BlakeGarner/blakegarner-kicad-library/README.md

# user-kicad-library
Blake's KiCad Library
