BlakeGarner/blakegarner-kicad-library/kicad-packages3d/Button_Switch_BG/src/TE_Alcoswitch_SPST_LED.FCStd

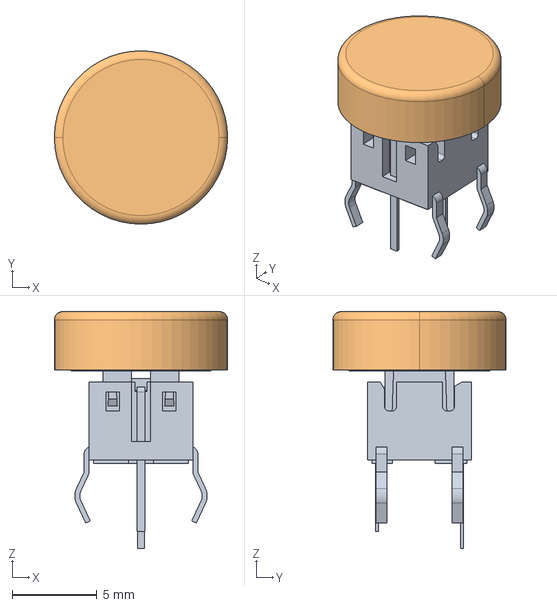
[picture p2: CAD file, 2020-06-05]
kicad-packages3d/Button_Switch_BG/src/TE_Alcoswitch_SPST_LED.FCStd
10.2 x 10.2 x 13.9 mm
SwitchChassis
SwitchCapRound
