BlakeGarner/blakegarner-kicad-library/kicad-packages3d/Button_Switch_BG/TE_Alcoswitch_SPST_LED_SquareCapBlack.step

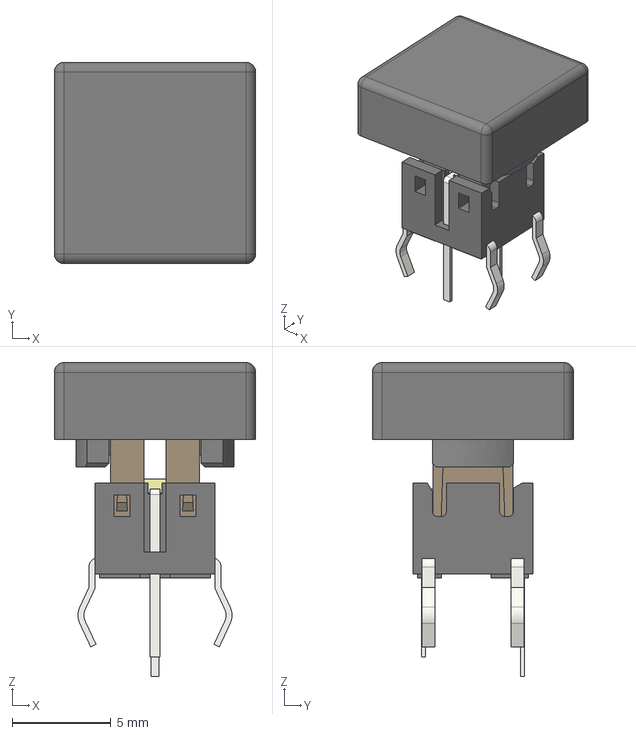
[picture p3: CAD file, 2020-09-09]
kicad-packages3d/Button_Switch_BG/TE_Alcoswitch_SPST_LED_SquareCapBlack.step
10.2 x 10.2 x 15.9 mm
