BlakeGarner/blakegarner-kicad-library/kicad-packages3d/Connector_BG/00BarrierBlock_TE_1x02_P0.375in_6DBL-02-006.stp

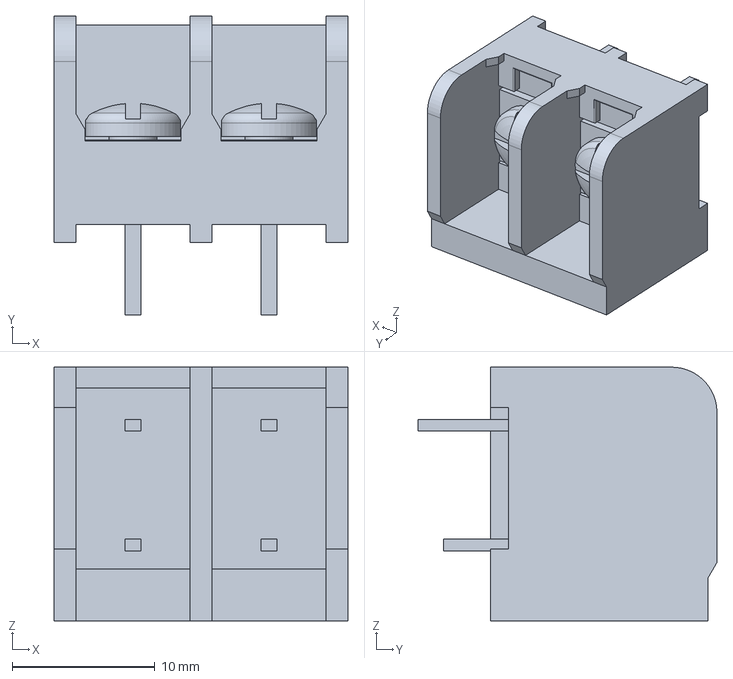
[picture p4: CAD file, 2019-09-27]
kicad-packages3d/Connector_BG/00BarrierBlock_TE_1x02_P0.375in_6DBL-02-006.stp
20.6 x 21.0 x 17.8 mm
