BlakeGarner/blakegarner-kicad-library/kicad-packages3d/Display_BG/0.91in_OLED_Module_Without_Glass.step

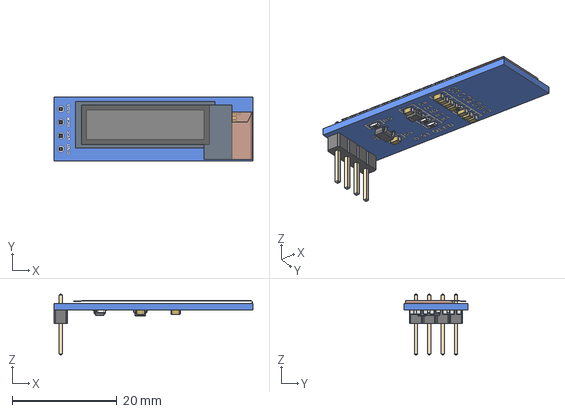
[picture p6: CAD file, 2019-06-12]
kicad-packages3d/Display_BG/0.91in_OLED_Module_Without_Glass.step
37.9 x 12.1 x 11.5 mm
