BlakeGarner/blakegarner-kicad-library/kicad-packages3d/Display_BG/src/Display_OLED_128x32_I2C.FCStd

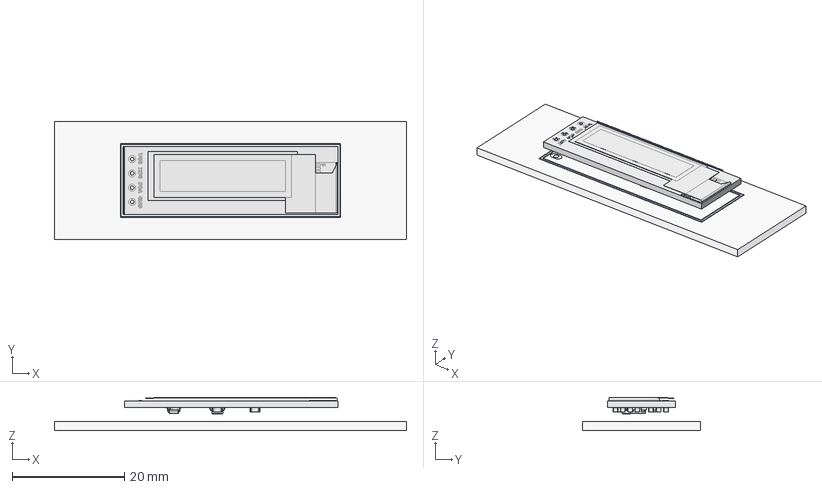
[picture p7: CAD file, 2019-06-12]
kicad-packages3d/Display_BG/src/Display_OLED_128x32_I2C.FCStd
62.6 x 21.0 x 5.89 mm
FCrtYd
FrontSilk
TopPads
BotPads
PTHs
Pcb
__91in_OLED_Module___Without_Glass_cp
