BlakeGarner/blakegarner-kicad-library/kicad-packages3d/Encoder_BG/PEC12R-4X20F-SXXX.step

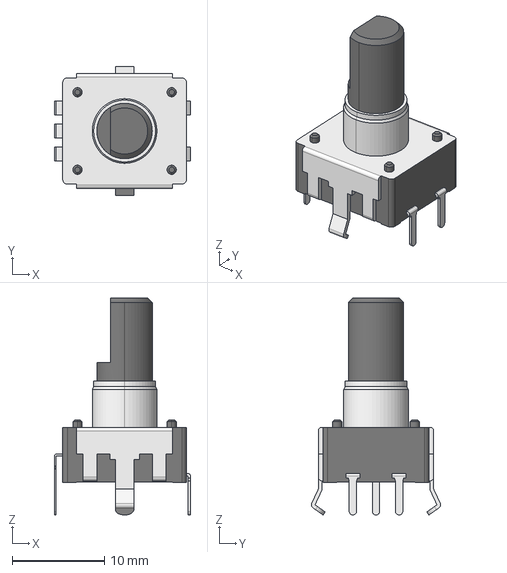
[picture p8: CAD file, 2019-06-12]
kicad-packages3d/Encoder_BG/PEC12R-4X20F-SXXX.step
14.7 x 14.0 x 23.5 mm
