BlakeGarner/blakegarner-kicad-library/kicad-packages3d/Encoder_BG/src/PEC11R-4x20k-Sxxxx.FCStd

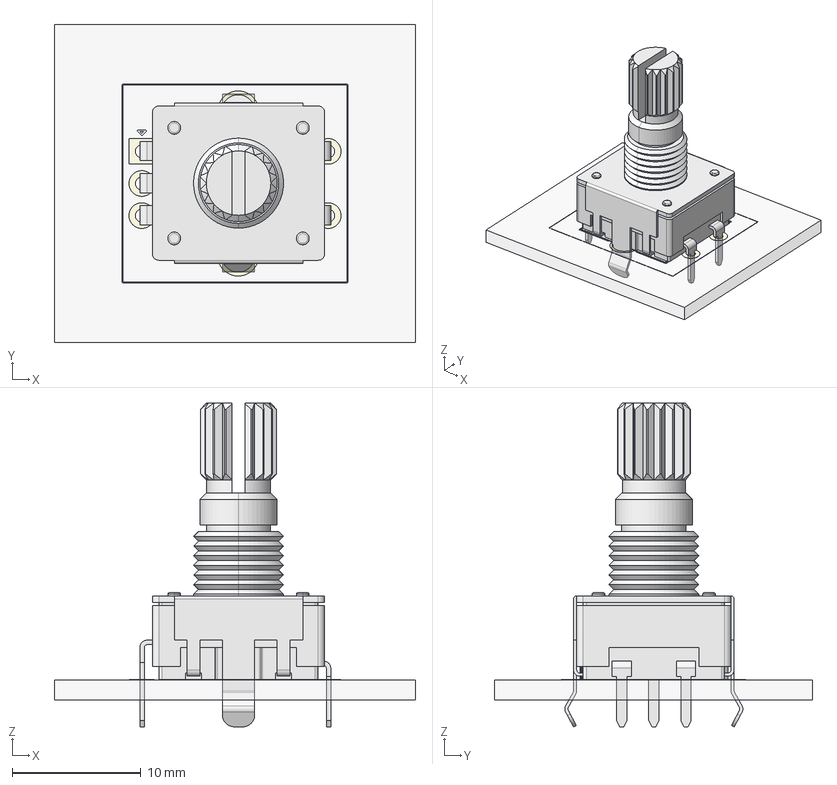
[picture p9: CAD file, 2019-06-12]
kicad-packages3d/Encoder_BG/src/PEC11R-4x20k-Sxxxx.FCStd
28.1 x 24.7 x 25.2 mm
FCrtYd
FFab
FrontSilk
TopPads
BotPads
PTHs
Pcb
PEC11R_4215K_L13_8_W12_4_H21_5_cp001_cp
