BlakeGarner/blakegarner-kicad-library/kicad-packages3d/Encoders/PEC11R-4x20k-Sxxxx.step

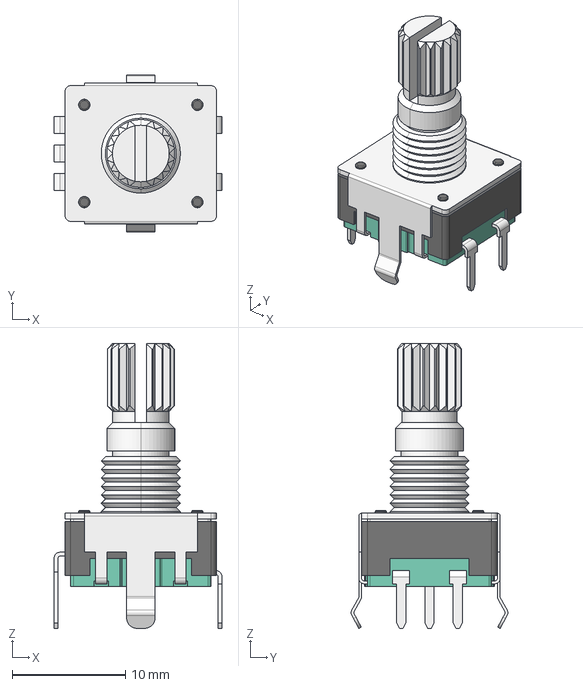
[picture p10: CAD file, 2019-06-10]
kicad-packages3d/Encoders/PEC11R-4x20k-Sxxxx.step
14.9 x 13.9 x 25.2 mm
