BlakeGarner/blakegarner-kicad-library/kicad-packages3d/Fuse_BG/BladeFuse_ATO_Keystone_3557-2.stl

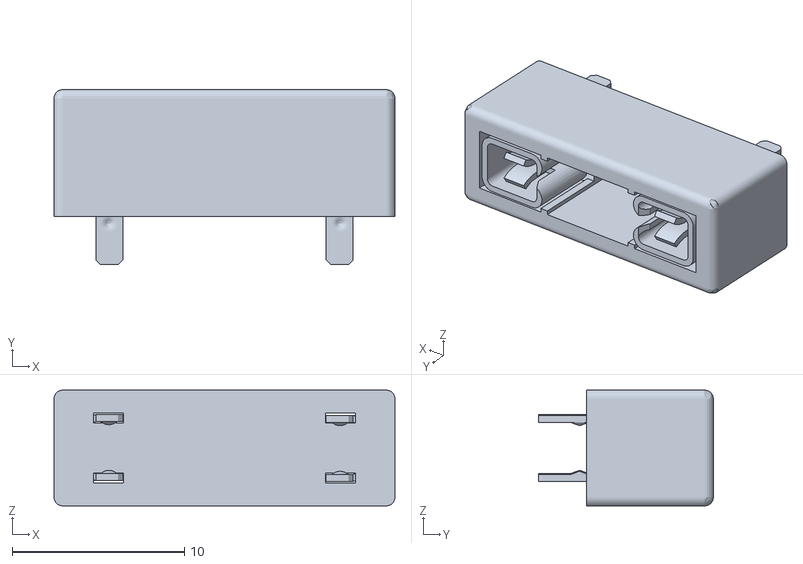
[picture p11: CAD file, 2019-09-27]
kicad-packages3d/Fuse_BG/BladeFuse_ATO_Keystone_3557-2.stl
19.8 x 10.2 x 6.73
