BlakeGarner/blakegarner-kicad-library/kicad-packages3d/Inductor_BG/Inductor_SMD_12x12mm.step

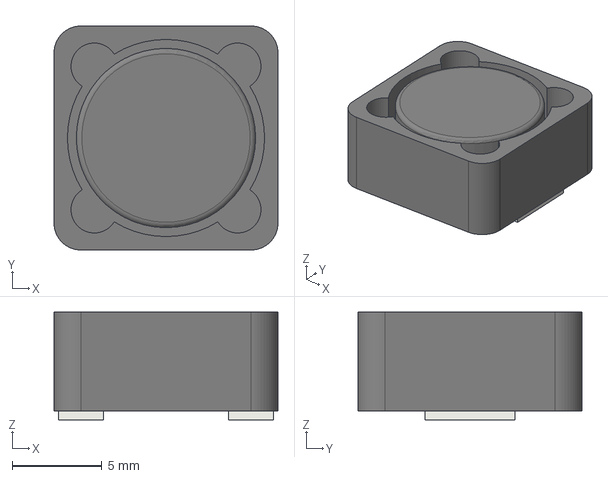
[picture p12: CAD file, 2019-09-27]
kicad-packages3d/Inductor_BG/Inductor_SMD_12x12mm.step
12.5 x 12.5 x 6.00 mm
