BlakeGarner/blakegarner-kicad-library/kicad-packages3d/LED_BG/LED_PLCC2.step

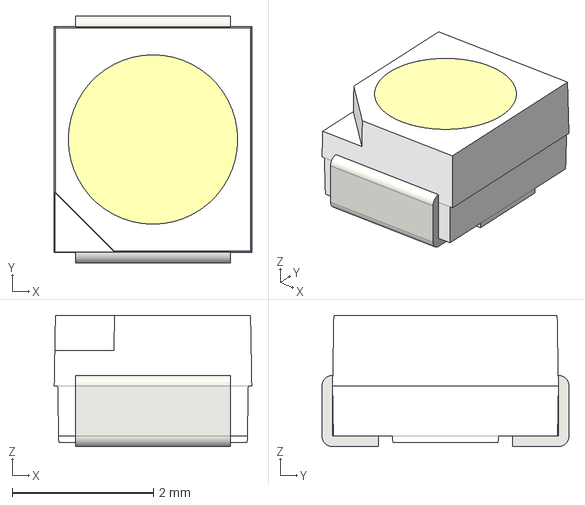
[picture p13: CAD file, 2019-09-27]
kicad-packages3d/LED_BG/LED_PLCC2.step
2.80 x 3.50 x 1.86 mm
