BlakeGarner/blakegarner-kicad-library/kicad-packages3d/LED_BG/src/LED_CREE_CLM1B-M.step

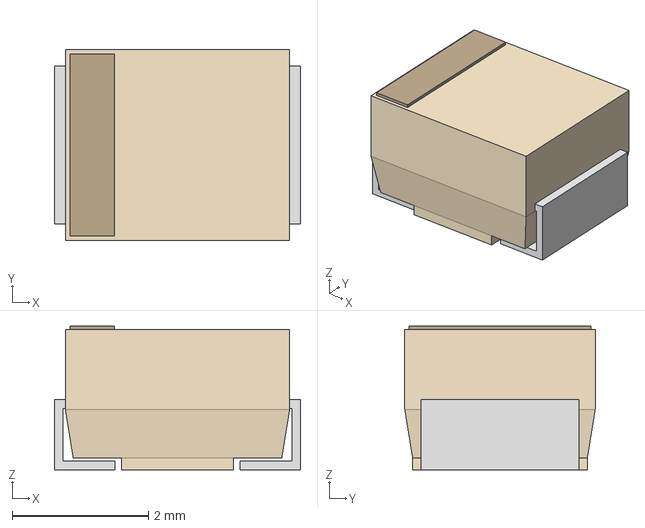
[picture p14: CAD file, 2019-09-27]
kicad-packages3d/LED_BG/src/LED_CREE_CLM1B-M.step
3.61 x 2.79 x 2.11 mm
