BlakeGarner/blakegarner-kicad-library/kicad-packages3d/Module_Meanwell_BG/Meanwell_NSD15_S_cp.step

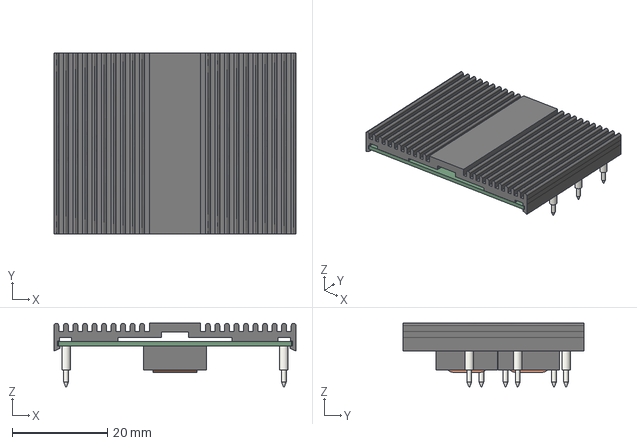
[picture p15: CAD file, 2019-09-27]
kicad-packages3d/Module_Meanwell_BG/Meanwell_NSD15_S_cp.step
50.8 x 38.1 x 13.3 mm
