BlakeGarner/blakegarner-kicad-library/kicad-packages3d/Module_Meanwell_BG/src/Meanwell_NSD15-S.FCStd

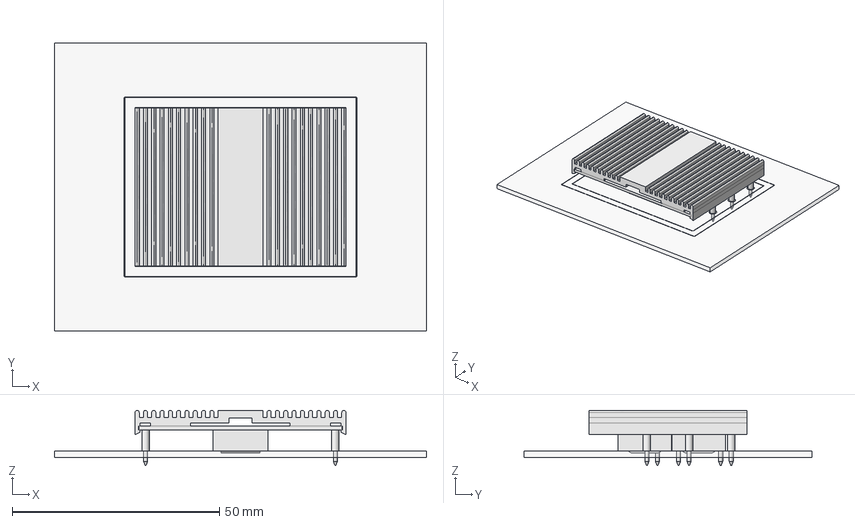
[picture p16: CAD file, 2019-09-27]
kicad-packages3d/Module_Meanwell_BG/src/Meanwell_NSD15-S.FCStd
89.6 x 69.3 x 13.3 mm
FCrtYd
FFab
TopPads
BotPads
PTHs
Pcb
Meanwell_NSD15_S_cp
