BlakeGarner/blakegarner-kicad-library/kicad-packages3d/Module_RaspberryPi_BG/RaspberryPi_3BPlus_Headers_cp.step

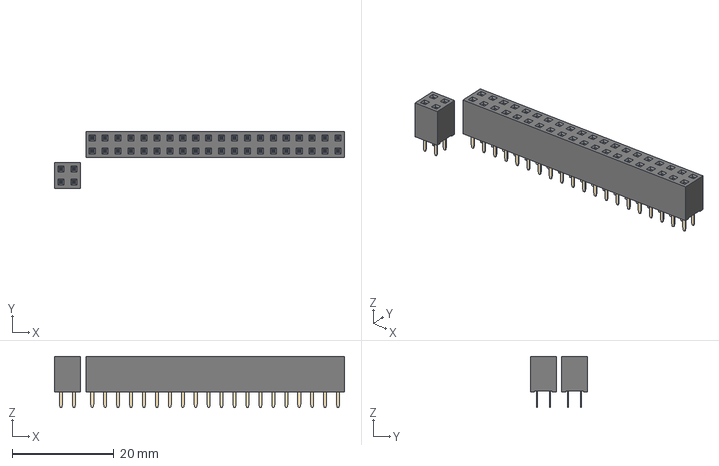
[picture p17: CAD file, 2019-09-27]
kicad-packages3d/Module_RaspberryPi_BG/RaspberryPi_3BPlus_Headers_cp.step
56.9 x 11.2 x 10.1 mm
