BlakeGarner/blakegarner-kicad-library/kicad-packages3d/Module_RaspberryPi_BG/src/raspberry_pi_4_full_model/Microphone Plug, RPi4ModelB.SLDPRT

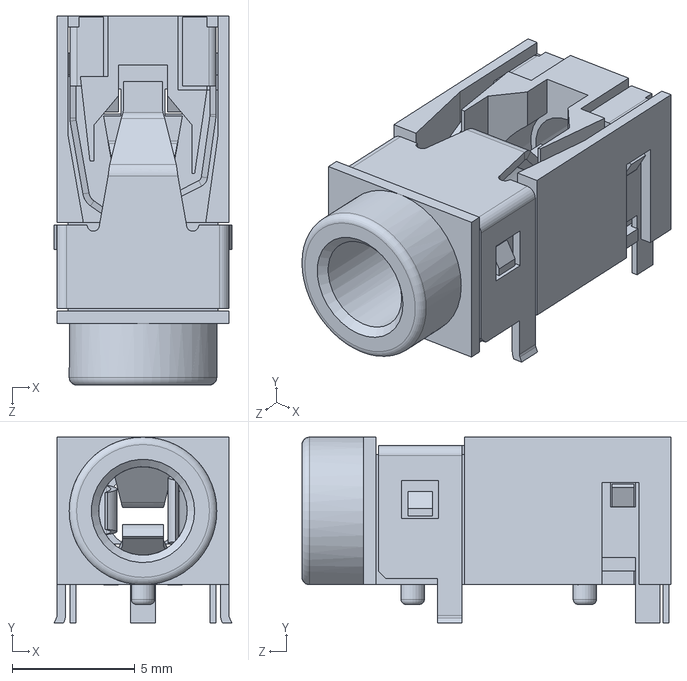
[picture p18: CAD file, 2019-09-30]
kicad-packages3d/Module_RaspberryPi_BG/src/raspberry_pi_4_full_model/Microphone Plug, RPi4ModelB.SLDPRT
7.23 x 7.55 x 15.0 mm
