BlakeGarner/blakegarner-kicad-library/kicad-packages3d/Module_RaspberryPi_BG/src/RaspberryPi_3BPlus.FCStd

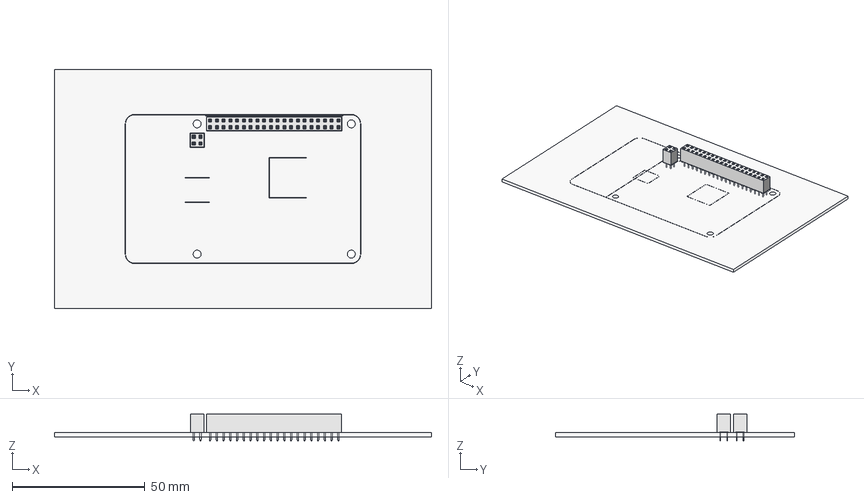
[picture p19: CAD file, 2019-09-27]
kicad-packages3d/Module_RaspberryPi_BG/src/RaspberryPi_3BPlus.FCStd
141.8 x 89.8 x 10.1 mm
FCrtYd
FFab
FrontSilk
TopPads
BotPads
PTHs
Pcb
RaspberryPi_3BPlus_Headers_cp
