BlakeGarner/blakegarner-kicad-library/kicad-packages3d/SOIC_BG/SOIC-8_5.3x5.3mm_P1.27mm.step

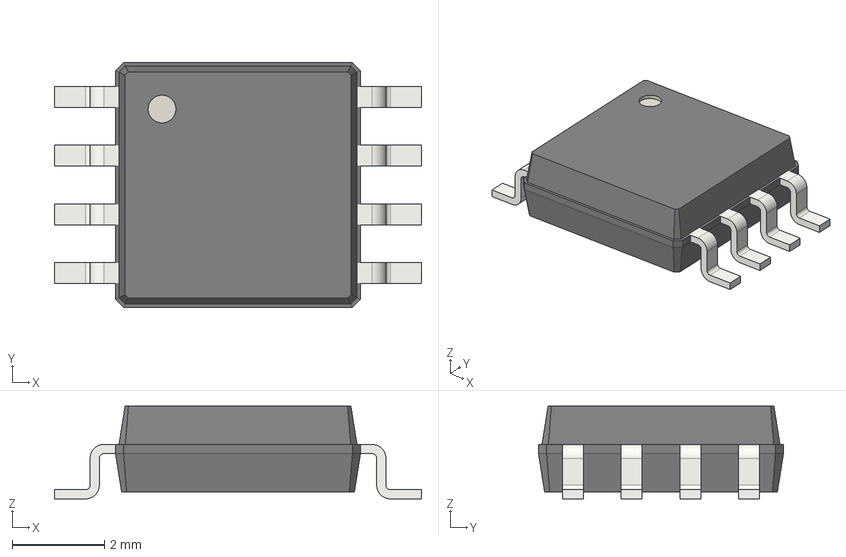
[picture p20: CAD file, 2019-09-27]
kicad-packages3d/SOIC_BG/SOIC-8_5.3x5.3mm_P1.27mm.step
7.94 x 5.30 x 2.01 mm
