BlakeGarner/blakegarner-kicad-library/kicad-packages3d/Teensy_BG/src/Teensy_3.0_3.1_3.2.FCStd

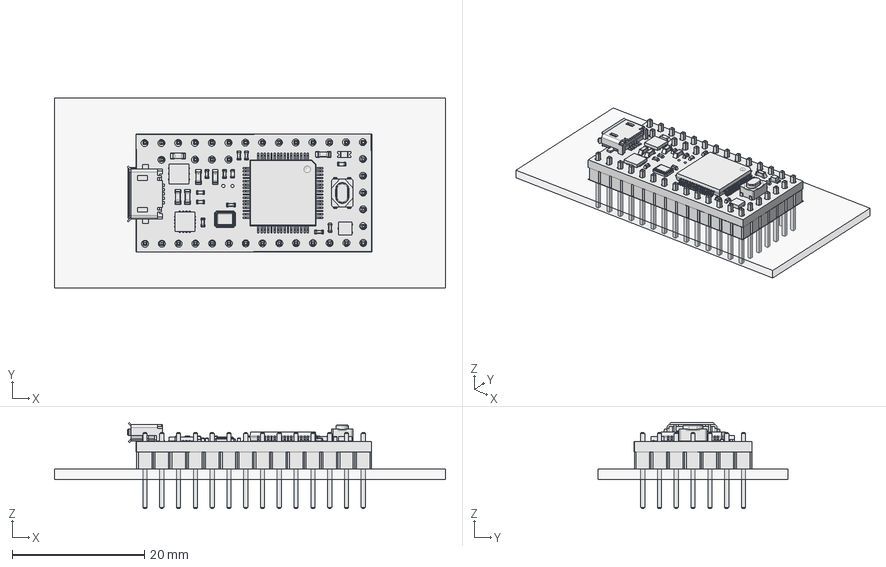
[picture p21: CAD file, 2019-06-12]
kicad-packages3d/Teensy_BG/src/Teensy_3.0_3.1_3.2.FCStd
59.2 x 28.7 x 13.0 mm
FrontSilk
TopPads
BotPads
PTHs
Pcb
Teensy_3_1_v13001_cp
