BlakeGarner/blakegarner-kicad-library/kicad-packages3d/TO_SOT_BG/TSOT-23-6_MK06A.step

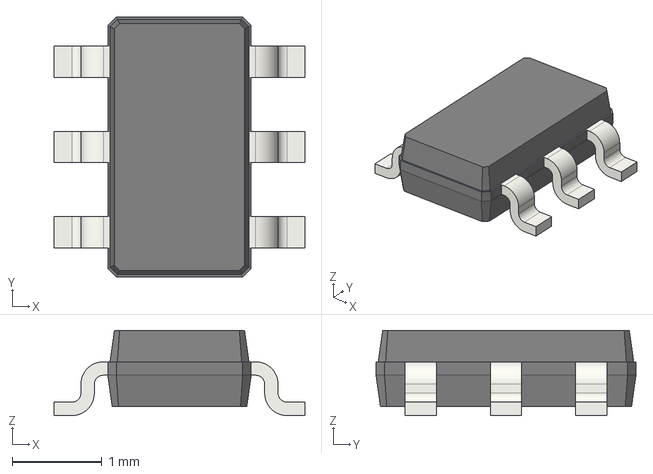
[picture p22: CAD file, 2019-09-27]
kicad-packages3d/TO_SOT_BG/TSOT-23-6_MK06A.step
2.80 x 2.90 x 0.95 mm
