BlakeGarner/blakegarner-kicad-library/kicad-packages3d/Button_Switch_BG/src/CK_AYZ0202AGRLC.FCStd

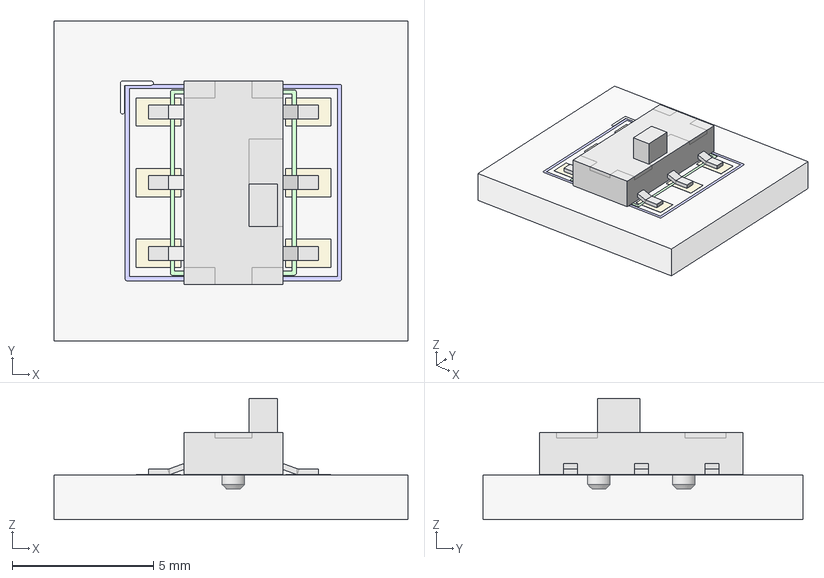
[picture p23: CAD file, 2019-09-27]
kicad-packages3d/Button_Switch_BG/src/CK_AYZ0202AGRLC.FCStd
12.5 x 11.3 x 4.29 mm
FCrtYd
FFab
FrontSilk
TopPads
PTHs
Pcb
CK_AYZ0202AGRLC_cp
