BlakeGarner/blakegarner-kicad-library/kicad-packages3d/Button_Switch_BG/TE_Alcoswitch_SPST_LED.step

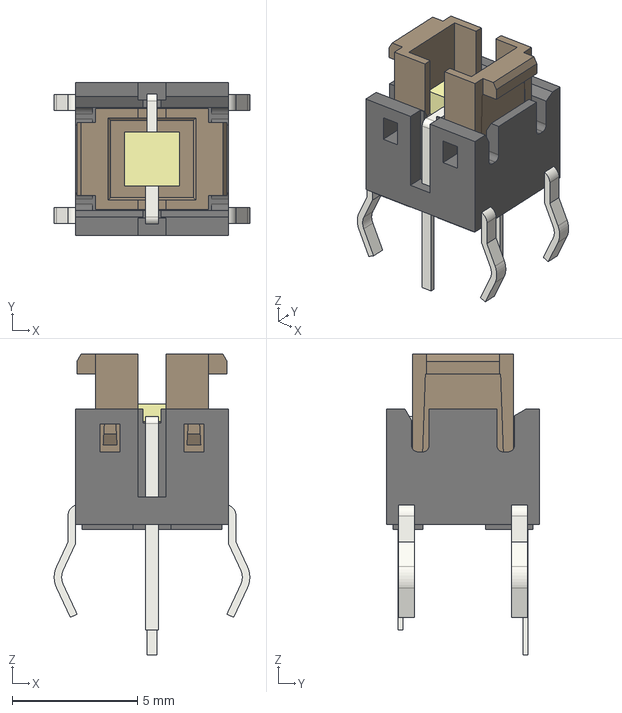
[picture p24: CAD file, 2020-06-05]
kicad-packages3d/Button_Switch_BG/TE_Alcoswitch_SPST_LED.step
7.80 x 6.10 x 12.0 mm
