BlakeGarner/blakegarner-kicad-library/kicad-packages3d/Connector_BG/src/TerminalBlock_ED365-2_Angled_1x02_P7.50mm.FCStd

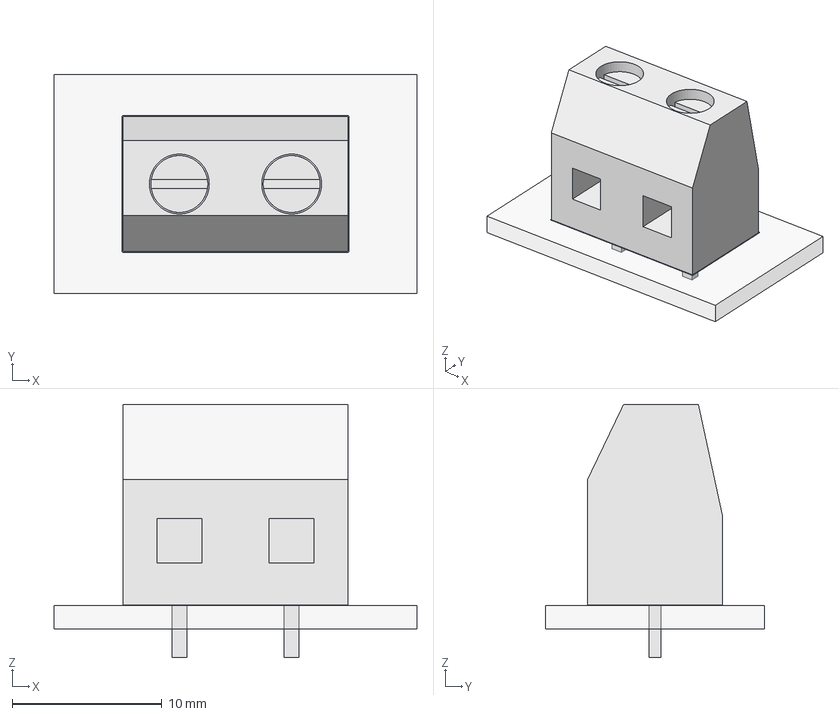
[picture p25: CAD file, 2019-09-27]
kicad-packages3d/Connector_BG/src/TerminalBlock_ED365-2_Angled_1x02_P7.50mm.FCStd
24.2 x 14.6 x 16.9 mm
FrontSilk
TopPads
BotPads
PTHs
Pcb
TerminalBlock_ED365_2_Angled_1x02_P7_50mm_cp
