BlakeGarner/blakegarner-kicad-library/kicad-packages3d/Connector_BG/TerminalBlock_TE_284391_4_Angled_1x04_P3_5mm_cp.step

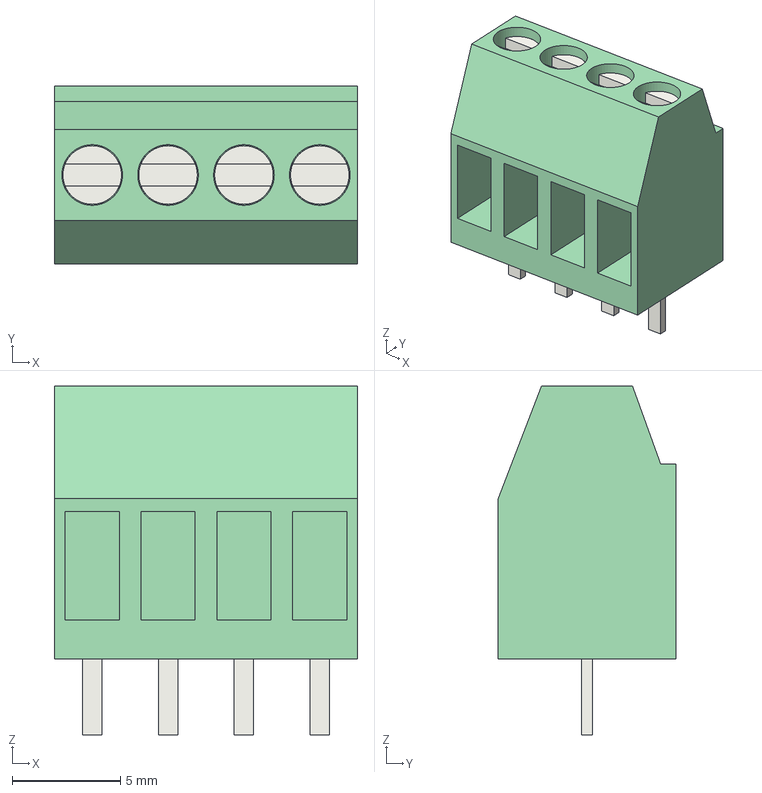
[picture p26: CAD file, 2019-09-27]
kicad-packages3d/Connector_BG/TerminalBlock_TE_284391_4_Angled_1x04_P3_5mm_cp.step
14.0 x 8.20 x 16.1 mm
