BlakeGarner/blakegarner-kicad-library/kicad-packages3d/Encoder_BG/src/PEC12R-4x20k-Sxxxx.FCStd

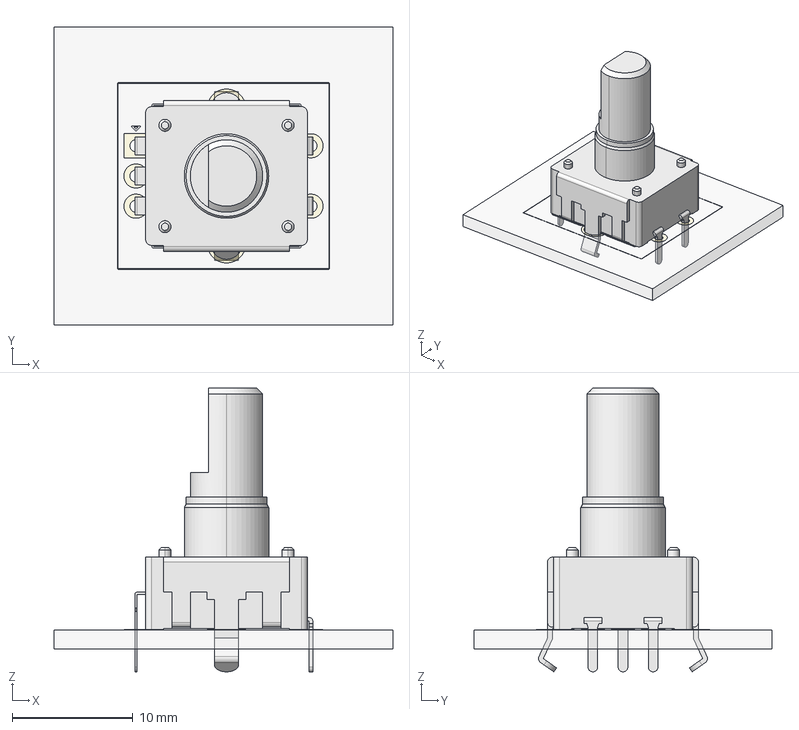
[picture p27: CAD file, 2019-06-12]
kicad-packages3d/Encoder_BG/src/PEC12R-4x20k-Sxxxx.FCStd
28.1 x 24.7 x 23.5 mm
FCrtYd001
FFab001
FrontSilk001
TopPads001
BotPads001
PTHs001
Pcb001
PEC12R-4X20F-SXXX
