BlakeGarner/blakegarner-kicad-library/kicad-packages3d/Fuse_BG/SMD_Polyfuse_1210.step

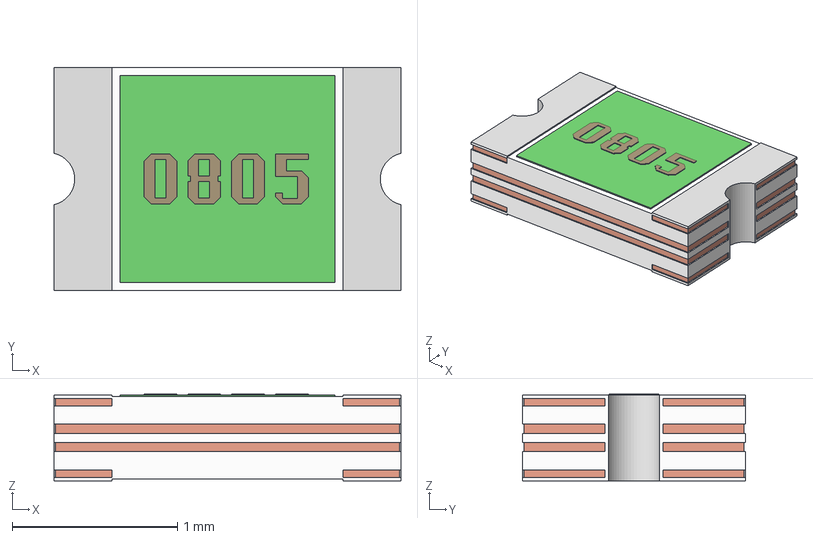
[picture p28: CAD file, 2019-09-27]
kicad-packages3d/Fuse_BG/SMD_Polyfuse_1210.step
2.10 x 1.35 x 0.525 mm
