BlakeGarner/blakegarner-kicad-library/kicad-packages3d/Fuse_BG/src/BladeFuse_ATO_Keystone_3557.FCStd

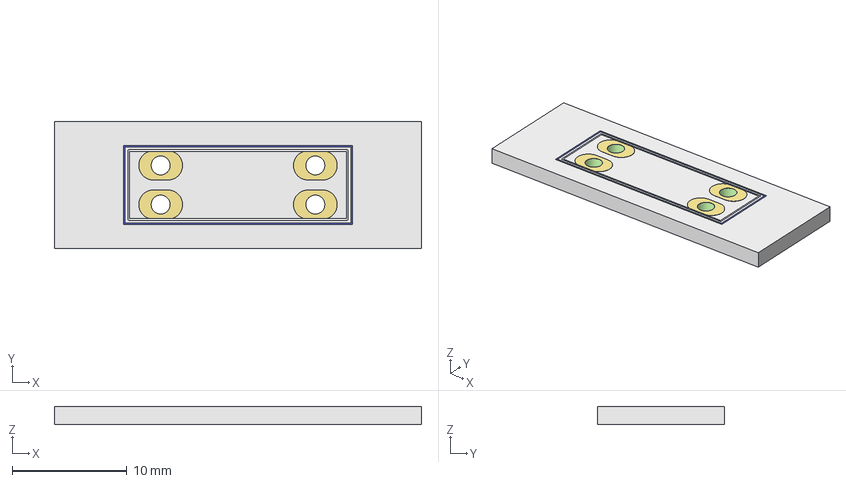
[picture p29: CAD file, 2019-09-30]
kicad-packages3d/Fuse_BG/src/BladeFuse_ATO_Keystone_3557.FCStd
31.9 x 11.0 x 1.61 mm
FCrtYd
FrontSilk
TopPads
BotPads
PTHs
Pcb
