BlakeGarner/blakegarner-kicad-library/kicad-packages3d/LED_BG/src/LED_PLCC2_AK.FCStd

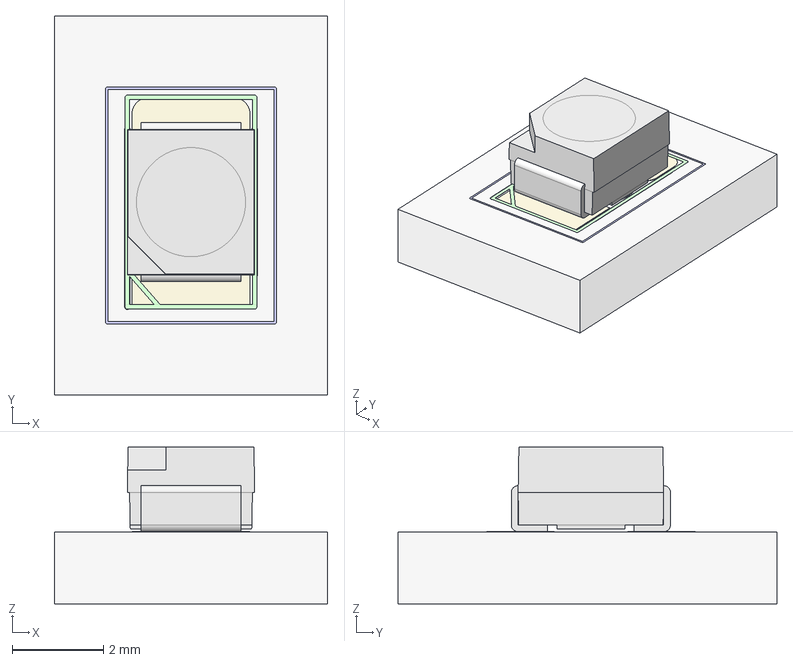
[picture p30: CAD file, 2019-09-27]
kicad-packages3d/LED_BG/src/LED_PLCC2_AK.FCStd
6.00 x 8.32 x 3.45 mm
FCrtYd
FFab
FrontSilk
TopPads
Pcb
User_Library_Everlight_67_21SRC_TR8_cp
