BlakeGarner/blakegarner-kicad-library/kicad-packages3d/LED_BG/WS2812_RGB_LED_updated.stp

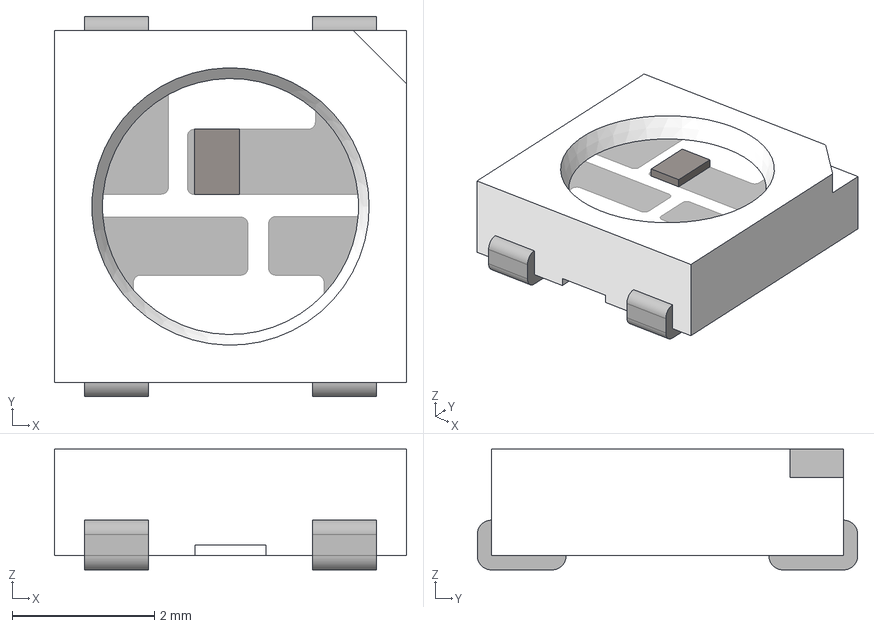
[picture p31: CAD file, 2019-06-12]
kicad-packages3d/LED_BG/WS2812_RGB_LED_updated.stp
4.95 x 5.35 x 1.70 mm
