BlakeGarner/blakegarner-kicad-library/kicad-packages3d/Module_RaspberryPi_BG/src/raspberry_pi_4_full_model/2.54 mm DUPONT MALE PIN HEADER, POE, 2X2, RPi4ModelB.SLDPRT

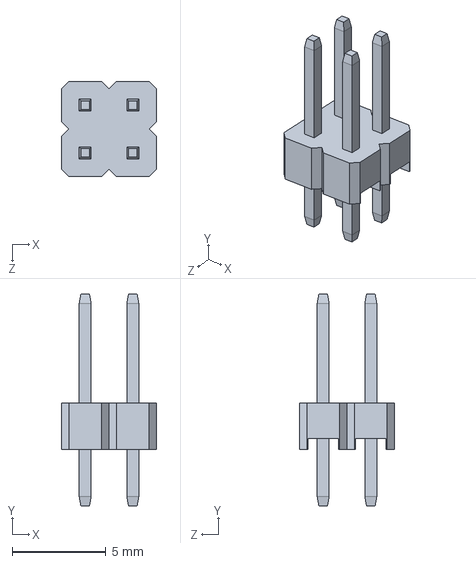
[picture p32: CAD file, 2019-09-30]
kicad-packages3d/Module_RaspberryPi_BG/src/raspberry_pi_4_full_model/2.54 mm DUPONT MALE PIN HEADER, POE, 2X2, RPi4ModelB.SLDPRT
5.08 x 11.3 x 5.08 mm
