BlakeGarner/blakegarner-kicad-library/kicad-packages3d/Button_Switch_BG/CK_AYZ0202AGRLC_cp.step

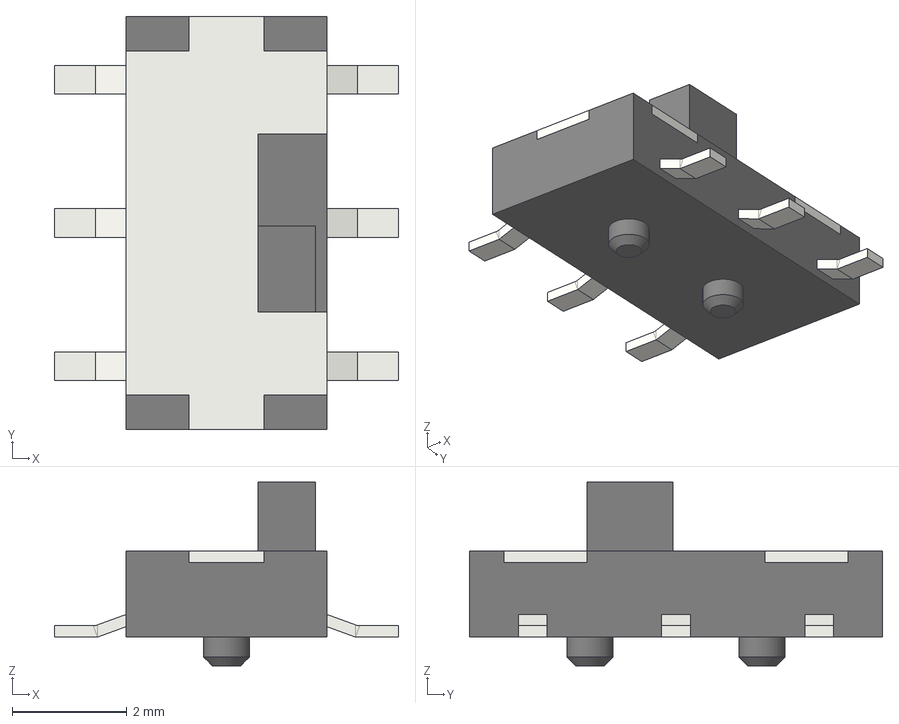
[picture p33: CAD file, 2019-09-27]
kicad-packages3d/Button_Switch_BG/CK_AYZ0202AGRLC_cp.step
6.00 x 7.20 x 3.20 mm
