BlakeGarner/blakegarner-kicad-library/kicad-packages3d/Button_Switch_BG/src/TL3240F160x.FCStd

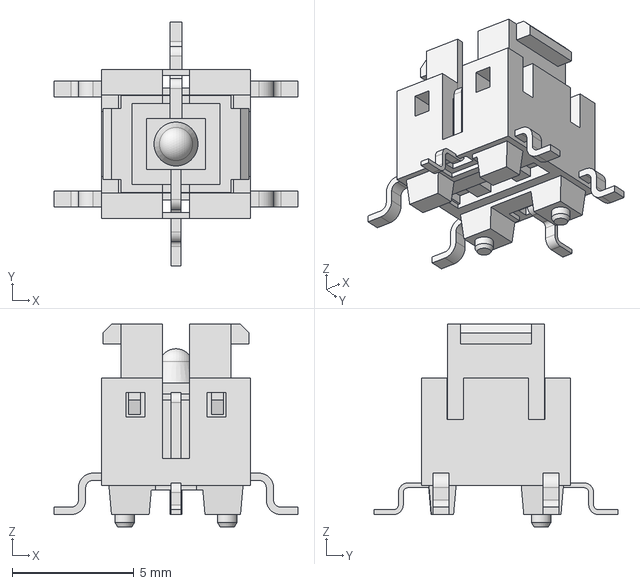
[picture p34: CAD file, 2019-06-12]
kicad-packages3d/Button_Switch_BG/src/TL3240F160x.FCStd
10.00 x 10.00 x 8.30 mm
