BlakeGarner/blakegarner-kicad-library/kicad-packages3d/Connector_BG/CUI_PJ-050AH.step

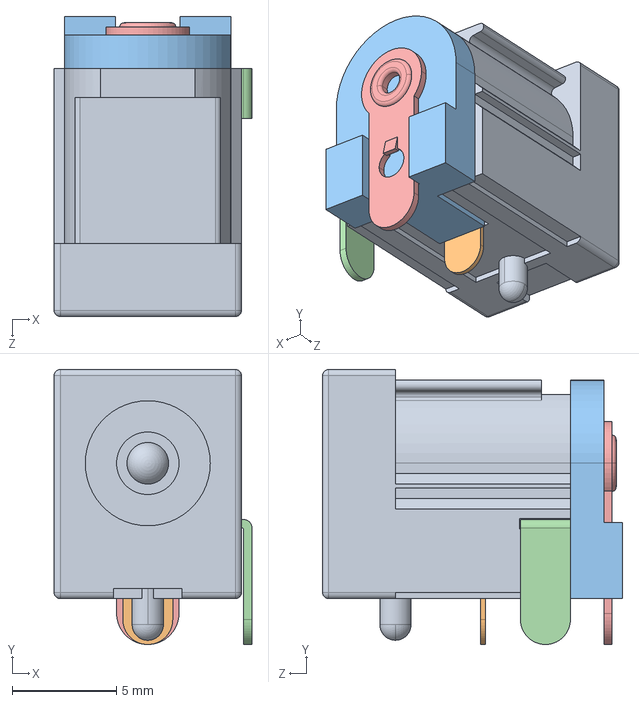
[picture p35: CAD file, 2019-09-27]
kicad-packages3d/Connector_BG/CUI_PJ-050AH.step
9.50 x 13.2 x 14.4 mm
