BlakeGarner/blakegarner-kicad-library/kicad-packages3d/Module_RaspberryPi_BG/src/raspberry_pi_4_full_model/Broadcom BCM54213PE Gigabit Ethernet Transceiver, RPi4ModelB.SLDPRT

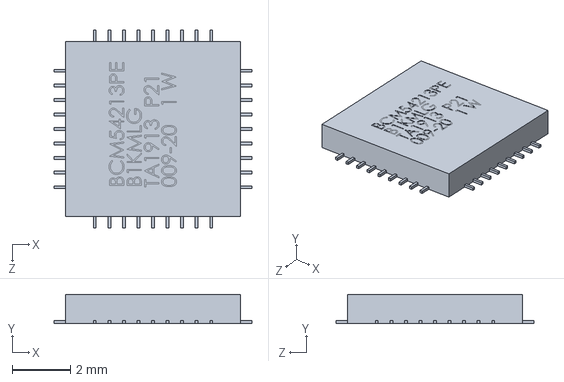
[picture p36: CAD file, 2019-09-30]
kicad-packages3d/Module_RaspberryPi_BG/src/raspberry_pi_4_full_model/Broadcom BCM54213PE Gigabit Ethernet Transceiver, RPi4ModelB.SLDPRT
6.80 x 1.00 x 6.80 mm
