BlakeGarner/blakegarner-kicad-library/kicad-packages3d/Button_Switch_BG/src/TL3240F160x_TL3240S1CAP.FCStd

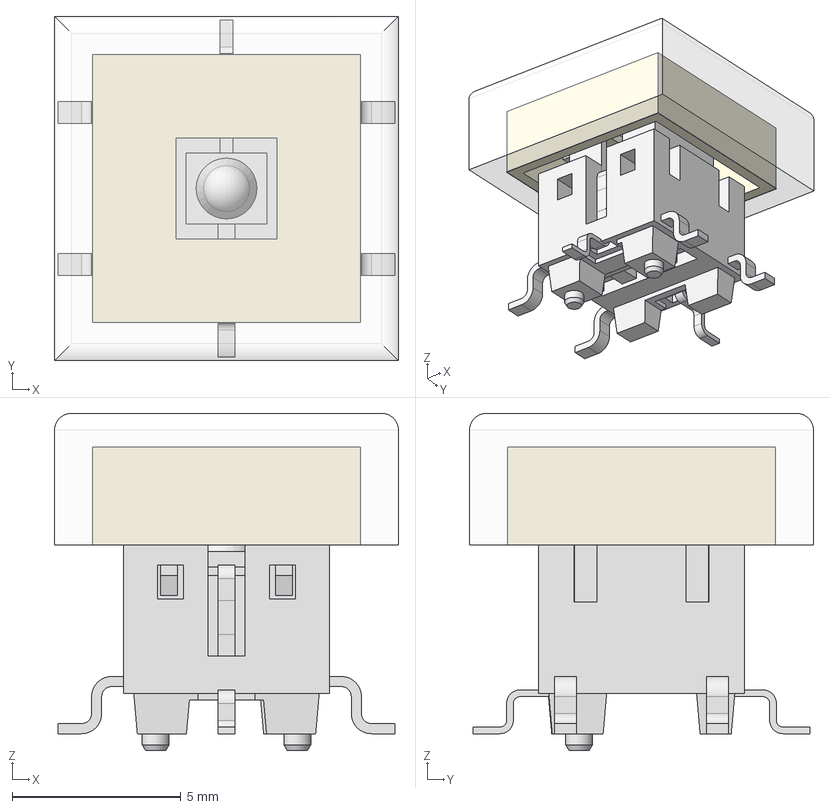
[picture p37: CAD file, 2019-06-12]
kicad-packages3d/Button_Switch_BG/src/TL3240F160x_TL3240S1CAP.FCStd
10.2 x 10.2 x 10.00 mm
TL3240xxxx
