BlakeGarner/blakegarner-kicad-library/kicad-packages3d/Button_Switch_BG/TL3240xxxx_TL3240R1CAP.step

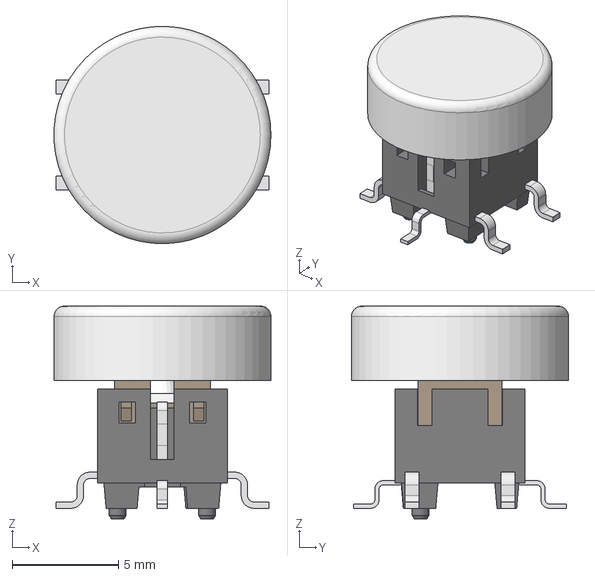
[picture p38: CAD file, 2019-06-12]
kicad-packages3d/Button_Switch_BG/TL3240xxxx_TL3240R1CAP.step
10.2 x 10.2 x 10.0 mm
