BlakeGarner/blakegarner-kicad-library/kicad-packages3d/Connector_BG/USB_Micro-B_Molex_47346-0001.step

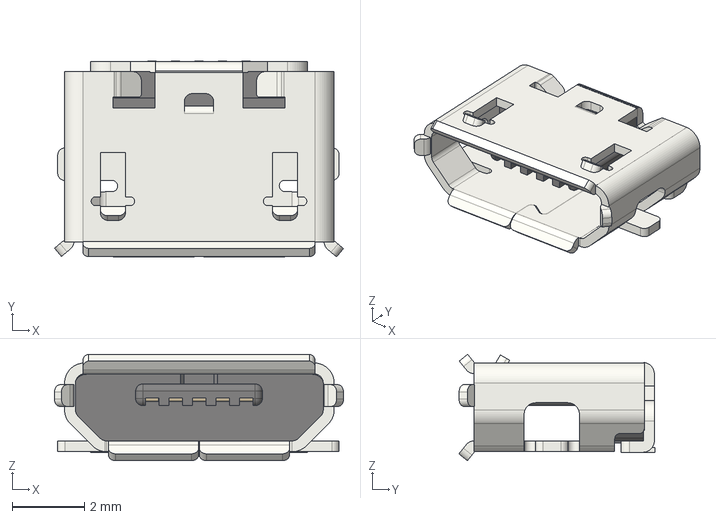
[picture p39: CAD file, 2019-09-27]
kicad-packages3d/Connector_BG/USB_Micro-B_Molex_47346-0001.step
7.98 x 5.42 x 2.94 mm
