BlakeGarner/blakegarner-kicad-library/kicad-packages3d/Fuse_BG/src/Polyfuse_0805_1210Metric.FCStd

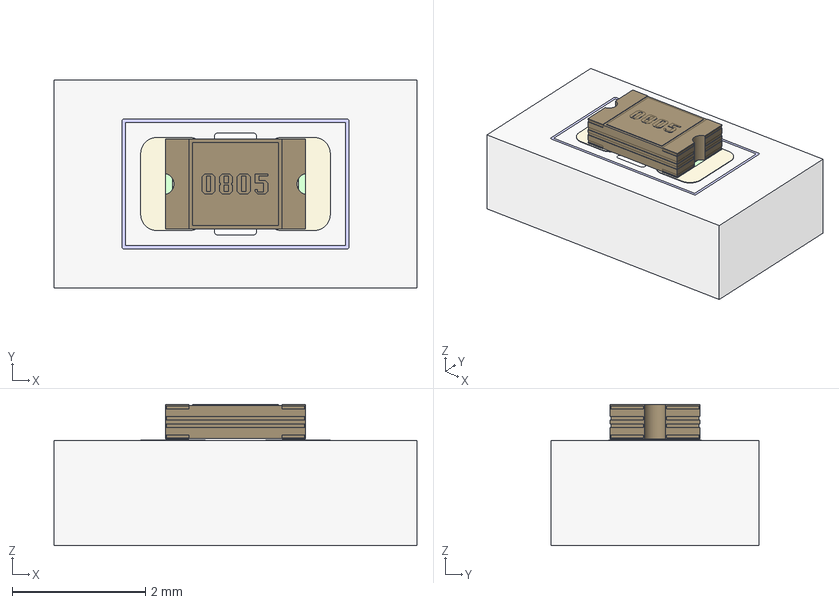
[picture p40: CAD file, 2019-09-27]
kicad-packages3d/Fuse_BG/src/Polyfuse_0805_1210Metric.FCStd
5.46 x 3.12 x 2.12 mm
FCrtYd
FFab
FrontSilk
TopPads
Pcb
SMD_Polyfuse_1210
