BlakeGarner/blakegarner-kicad-library/kicad-packages3d/Module_RaspberryPi_BG/src/raspberry_pi_4_full_model/Female Micro HDMI Connector, RPi4ModelB.SLDPRT

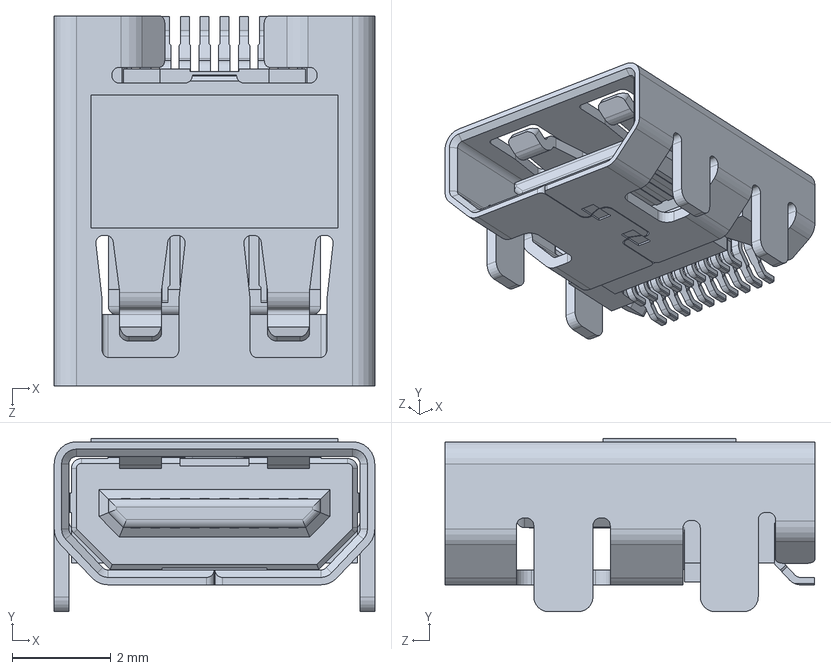
[picture p41: CAD file, 2019-09-30]
kicad-packages3d/Module_RaspberryPi_BG/src/raspberry_pi_4_full_model/Female Micro HDMI Connector, RPi4ModelB.SLDPRT
6.50 x 3.52 x 7.50 mm
