BlakeGarner/blakegarner-kicad-library/kicad-packages3d/Button_Switch_BG/src/E-Switch_TL3240S1CAPIVR.FCStd

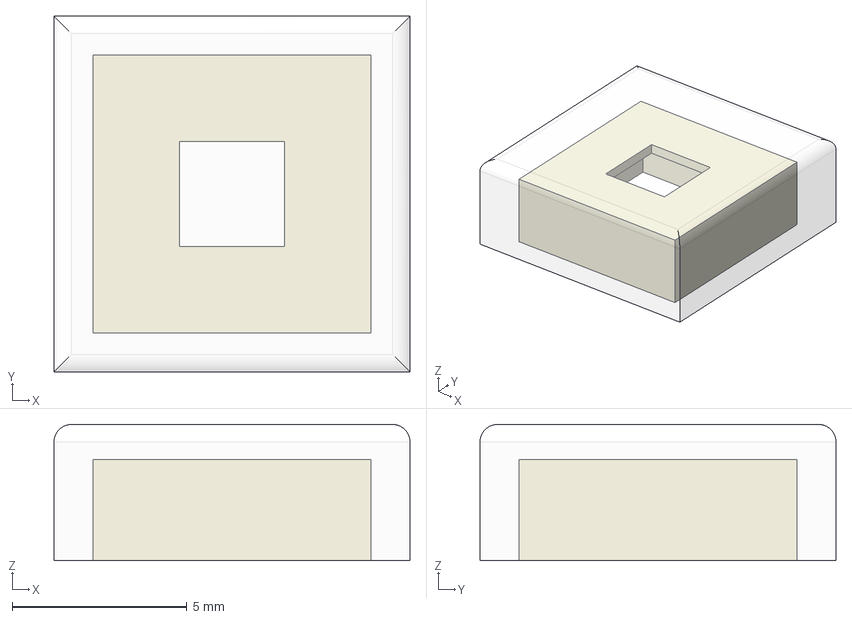
[picture p42: CAD file, 2019-06-12]
kicad-packages3d/Button_Switch_BG/src/E-Switch_TL3240S1CAPIVR.FCStd
10.2 x 10.2 x 3.90 mm
