BlakeGarner/blakegarner-kicad-library/kicad-packages3d/Connector_BG/src/TerminalBlock_1x04_P3.5mm.stl

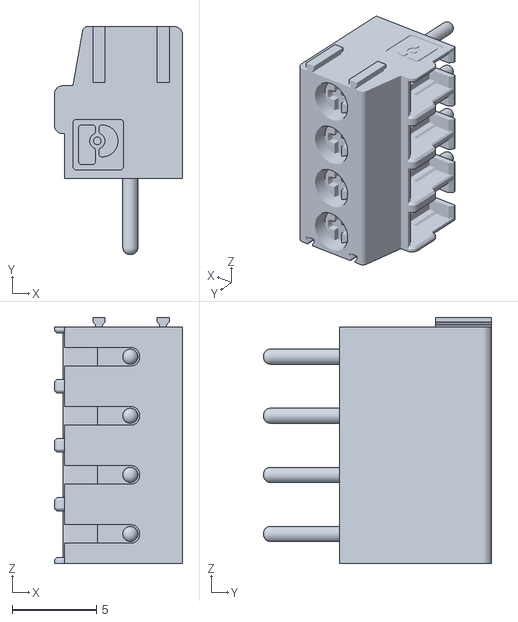
[picture p43: CAD file, 2019-09-27]
kicad-packages3d/Connector_BG/src/TerminalBlock_1x04_P3.5mm.stl
7.60 x 13.5 x 14.6
