BlakeGarner/blakegarner-kicad-library/kicad-packages3d/Connector_BG/TerminalBlock_ED365_2_Angled_1x02_P7_50mm_cp.step

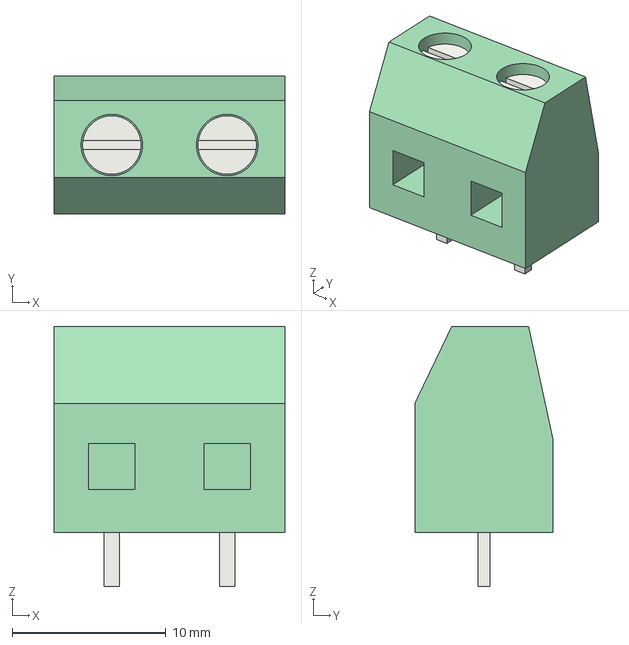
[picture p44: CAD file, 2019-09-27]
kicad-packages3d/Connector_BG/TerminalBlock_ED365_2_Angled_1x02_P7_50mm_cp.step
15.0 x 9.00 x 16.9 mm
