BlakeGarner/blakegarner-kicad-library/kicad-packages3d/Button_Switch_BG/src/E-Switch_TL3240R1CAPBLK.FCStd

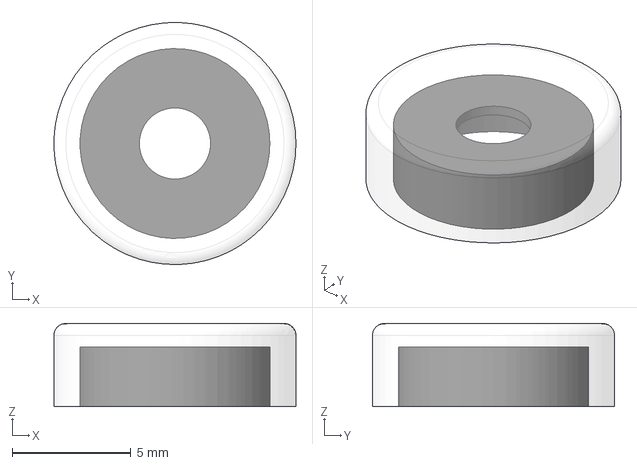
[picture p45: CAD file, 2019-06-12]
kicad-packages3d/Button_Switch_BG/src/E-Switch_TL3240R1CAPBLK.FCStd
10.2 x 10.2 x 3.50 mm
