BlakeGarner/blakegarner-kicad-library/kicad-packages3d/Connector_BG/BarrierBlock_TE_1x02_P0.375in_6DBL-02-006.step

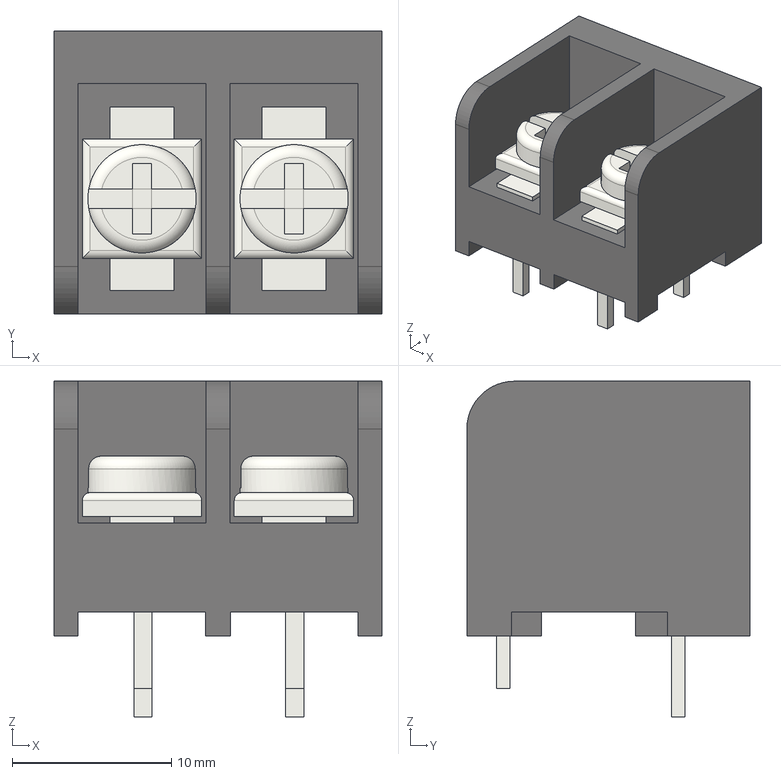
[picture p46: CAD file, 2019-09-27]
kicad-packages3d/Connector_BG/BarrierBlock_TE_1x02_P0.375in_6DBL-02-006.step
20.6 x 17.8 x 21.1 mm
