BlakeGarner/blakegarner-kicad-library/kicad-packages3d/Connector_BG/src/Barrier Block_6DBL-02-006.FCStd

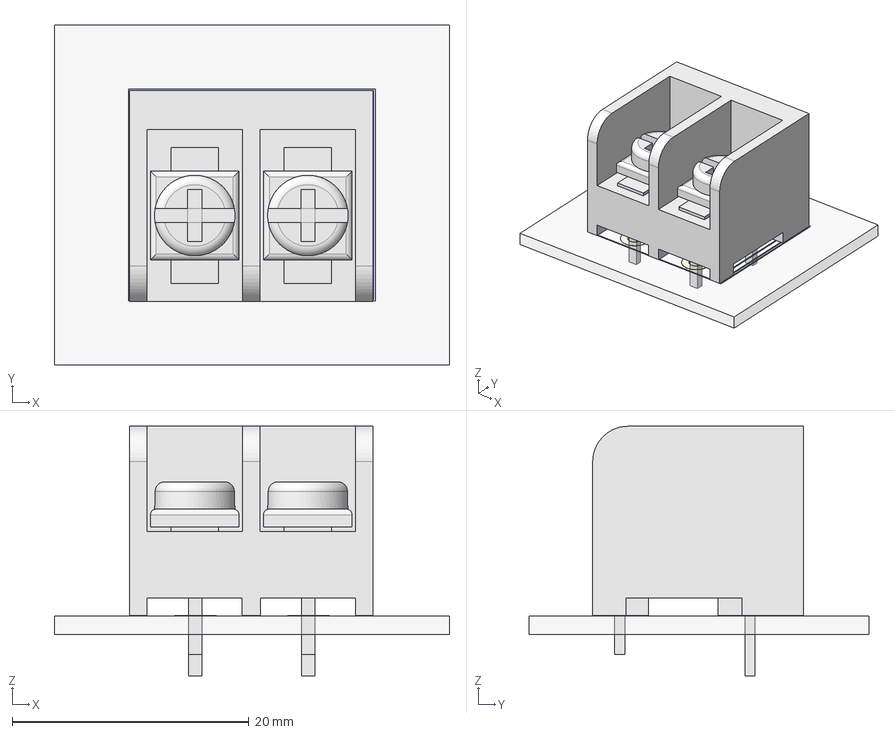
[picture p47: CAD file, 2019-09-27]
kicad-packages3d/Connector_BG/src/Barrier Block_6DBL-02-006.FCStd
33.4 x 28.7 x 21.1 mm
FCrtYd
FrontSilk
TopPads
BotPads
PTHs
Pcb
Barrier_Block_6DBL_02_006___Revised_cp
