BlakeGarner/blakegarner-kicad-library/kicad-packages3d/Button_Switch_BG/src/TL3240F160x_TL3240R1CAP.FCStd

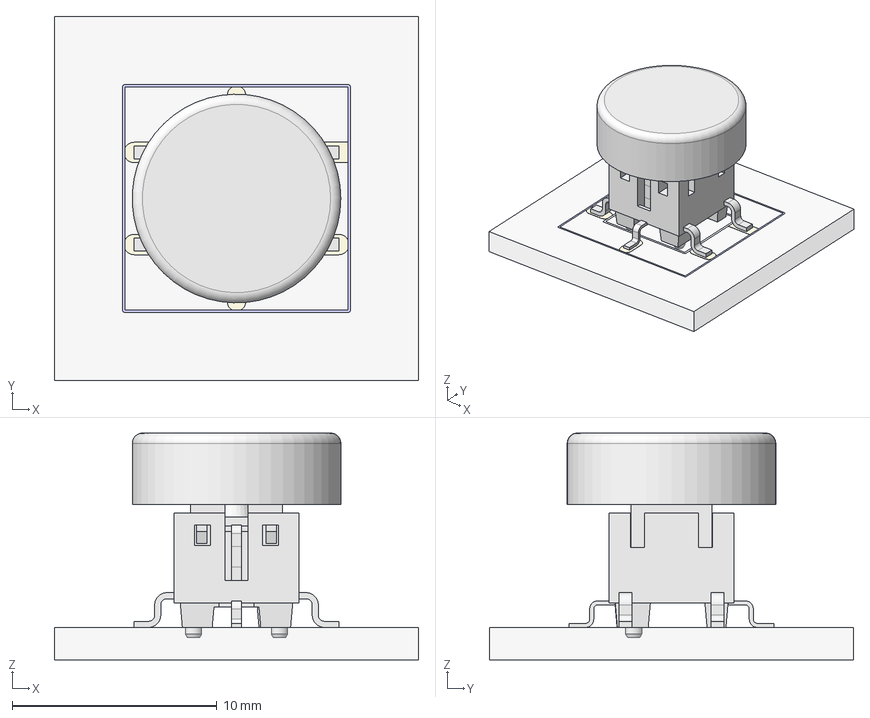
[picture p48: CAD file, 2019-06-12]
kicad-packages3d/Button_Switch_BG/src/TL3240F160x_TL3240R1CAP.FCStd
17.8 x 17.8 x 11.1 mm
FCrtYd
FrontSilk
TopPads
PTHs
Pcb
TL3240xxxx_TL3240R1CAP_cp
