BlakeGarner/blakegarner-kicad-library/kicad-packages3d/Connector_BG/src/TerminalBlock_TE_284391-4_Angled_1x04_P3.50mm.FCStd

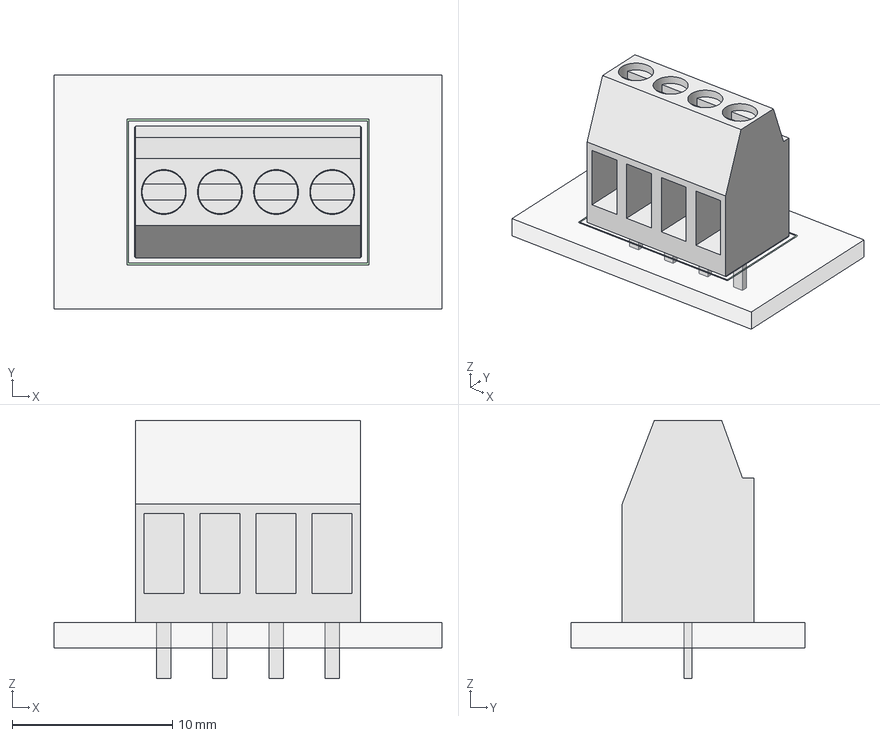
[picture p49: CAD file, 2019-09-27]
kicad-packages3d/Connector_BG/src/TerminalBlock_TE_284391-4_Angled_1x04_P3.50mm.FCStd
24.2 x 14.6 x 16.1 mm
FFab
FrontSilk
TopPads
BotPads
PTHs
Pcb
TerminalBlock_TE_284391_4_Angled_1x04_P3_5mm_cp
