BlakeGarner/blakegarner-kicad-library/(list of files, cad)

Other CAD files:
kicad-packages3d/Fuse_BG/src/BladeFuse_ATO_Keystone_3557-4.stl
kicad-packages3d/Encoder_BG/PEC11R-4x20K-Sxxxx.step
kicad-packages3d/Connector_BG/src/CUI_PJ-050AH.stl
kicad-packages3d/Fuse_BG/src/SMD_Polyfuse_0805.stp
kicad-packages3d/LED_BG/src/LED_PLCC2.STEP
kicad-packages3d/LED_BG/src/LED_CREE_CLM1B.step
kicad-packages3d/Button_Switch_BG/TL3240xxxx_TL3240S1CAP.step
kicad-packages3d/LED_BG/src/LED_CREE_CLM1B-L.step
kicad-packages3d/Connector_BG/src/BarrierBlock_TE_1x02_P0.375in_6DBL-02-006-02.stl
kicad-packages3d/Connector_BG/src/BarrierBlock_TE_1x02_P0.375in_6DBL-02-006.igs
kicad-packages3d/Connector_BG/src/BarrierBlock_TE_1x02_P0.375in_6DBL-02-006.stl
kicad-packages3d/LED_BG/src/LED_PLCC2.STL
