BlakeGarner/blakegarner-kicad-library/(commit log)

2019-06-01 Added symbols for Teensy.
2019-06-02 Filled in Teensy symbol
2019-06-10 Updated Display module to remove RESET pin.
2019-06-10 Added PEC11R encoder footprint and 3D model.
    [PEC11R-4x20k-Sxxxx.FCStd, PEC11R-4x20k-Sxxxx.step]
2019-06-12 Updated PEC11R/PEC12R encoder footprint and model.
    [PEC11R-4x20K-Sxxxx.step, PEC11R-4x20k-Sxxxx.FCStd, PEC12R-4X20F-SXXX.step, PEC12R-4x20k-Sxxxx.FCStd]
2019-06-12 Added symbols, footprint and 3D models for the E-Switch TL3240xxxx push switches.
    [E-Switch_TL3240R1CAPBLK.FCStd, E-Switch_TL3240S1CAPIVR.FCStd, TL3240F160x.FCStd, TL3240F160x_TL3240R1CAP.FCStd, TL3240F160x_TL3240S1CAP.FCStd, TL3240xxxx_TL3240R1CAP.step, TL3240xxxx_TL3240S1CAP.step]
2019-06-12 Added custom footprints for SOIC-8, SOIC-20W, SOIC-28W, TSSOP-20 and TSSOP-24 packages.
2019-06-12 Added symbol, footprint and 3D model for the SSD1306 I2C OLED Display module.
    [0.91in_OLED_Module_Without_Glass.step, Display_OLED_128x32_I2C.FCStd]
2019-06-12 Added 3D model and footprint for the WS2812B LED
    [WS2812_RGB_LED_updated.stp]
2019-06-12 Added custom footprints for the 0805 resistor and 0805/1210 capacitor.
2019-06-12 Added symbols, footprint and 3D model for the Teensy 3.0/3.1/3.2.
    [Teensy_3.0_3.1_3.2.FCStd]
2019-07-11 Added RotaryEncoder with Mounting Point pin reverted. Added RotaryEncoder symbol with mounting point added.
2019-07-11 Added SOIC-14 footprint.
2019-07-15 Updated power pin assignment on Teensy_BG.lib.
2019-09-27 Updated library for LightComposerDriver Rev B.
    [00BarrierBlock_TE_1x02_P0.375in_6DBL-02-006.stp, Barrier Block_6DBL-02-006.FCStd, BarrierBlock_TE_1x02_P0.375in_6DBL-02-006-02.stl, BarrierBlock_TE_1x02_P0.375in_6DBL-02-006.igs, BarrierBlock_TE_1x02_P0.375in_6DBL-02-006.step, BarrierBlock_TE_1x02_P0.375in_6DBL-02-006.stl, BarrierBlock_TE_1x02_P0.375in_6DBL-02-006.stp, BladeFuse_ATO_Keystone_3557-2.stl]
2019-09-30 Fixed up a few symbols and added some RPi models
    [2.54 mm DUPONT MALE PIN HEADER, IO, 2X20, RPi4ModelB.SLDPRT, 2.54 mm DUPONT MALE PIN HEADER, IO, 2X40, RPi4ModelB.SLDPRT, 2.54 mm DUPONT MALE PIN HEADER, POE, 2X2, RPi4ModelB.SLDPRT, 2X USB2.0 PORTS, RPi4ModelB.SLDPRT, 2X USB3.0 PORTS, RPi4ModelB.SLDPRT, 91D77 D9WHV 778K, 4 GB LPDDR4 SDRAM, RPi4ModelB.SLDPRT, BladeFuse_ATO_Keystone_3557-2.stl, BladeFuse_ATO_Keystone_3557-4.stl]
2019-10-07 Created a Raspberry Pi 3B+ / 4 Template
2019-10-07 Added symbols/footprints for the VL53L1X breakout and bare chip.
2019-10-07 Added/adjusted symbols for the Adafruit Feather and MPR12112 touch sensors
2019-10-07 Added symbol for the NXP PCA9507 I2C extender/buffer
2019-10-07 Added Mouse Bites footprint to a new "Mechanical_BG" library.
2020-06-05 Added 3D Model and footprint for TE Alcoswitch SPST LED Button
    [TE_Alcoswitch_SPST_LED.FCStd, TE_Alcoswitch_SPST_LED.step]
2020-06-11 Some small fixes to the silkscreen/courtyard to these footprints:
    * Bourns PEC12R-4x20k-Sxxx
    * TE Alcoswitch SPST LED
2020-07-17 Added some more footprints for Prox Sensor board
2020-09-09 Widen anode pin hole for Alcoswitch.
    (Red LED has its wire gauges flipped from blue/green/amber for some reason).
    [TE_Alcoswitch_SPST_LED_SquareCapBlack.step]
